aindustriosa/UnderWaterComms/README.md

# UnderWaterComms
UnderWater ultrasonic communications project
