aindustriosa/UnderWaterComms/HW/Rpi_Hat/README.md

Raspberry Pi Hat including:
- ADS8685IPWR ADC
- MAX98357A DAC
