aindustriosa/UnderWaterComms/HW/Rpi_Hat/bom/20250225 - BOM.xlsx

References | Value | Footprint | Digi-Key_PN | Quantity | 2 units
C1, C4, C6, C8, C10, C13, C14, C17, C19, C22 | 1uF | C_0603_1608Metric | 1276-1019-1-ND | 10 | 20 | 1276-1019-1-ND
C3, C5, C7, C15, C16, C18 | 10uF | C_0603_1608Metric | 1276-1869-1-ND | 6 | 12 | 1276-1869-1-ND
C2, C9 | 4.7uF | C_0603_1608Metric | 1276-1784-1-ND | 2 | 4 | 1276-1784-1-ND
C11, C12 | 100nF | C_0603_1608Metric | 1276-1000-1-ND | 2 | 4 | 1276-1000-1-ND
C20, C21 | 220pF | C_0603_1608Metric | 1276-1986-1-ND | 2 | 4 | 1276-1986-1-ND
R1, R5, R6 | 100K | R_0603_1608Metric | RMCF0603FT100KCT-ND | 3 | 6 | RMCF0603FT100KCT-ND
R3, R4 | 10R | R_0603_1608Metric | RMCF0603FT10R0CT-ND | 2 | 4 | RMCF0603FT10R0CT-ND
R2 | 2K2 | R_0603_1608Metric | P2.2KGCT-ND | 1 | 2 | P2.2KGCT-ND
U1 | ADS8685IPWR | TSSOP-16_4.4x5mm_P0.65mm | 296-48485-1-ND | 1 | 2 | 296-48485-1-ND
U2 | MD112D-05B | Converter_DCDC_TRACO_TBA1-xxxxE_Dual_THT | 5943-MD112D-05B-ND | 1 | 2 | 5943-MD112D-05B-ND
U3 | INA126 | SOIC-8_3.9x4.9mm_P1.27mm | 296-38946-1-ND | 1 | 2 | 296-38946-1-ND
U4 | AP7380-33W5 | SOT-23-5 | AP7380-33W5-7DICT-ND | 1 | 2 | AP7380-33W5-7DICT-ND
U5 | MAX98357A | TQFN-16-1EP_3x3mm_P0.5mm_EP1.23x1.23mm | MAX98357AETE+TCT-ND | 1 | 2 | MAX98357AETE+TCT-ND
TP1, TP2, TP3, TP4, TP5, TP6, TP7 | TestPoint | TestPoint_Pad_2.0x2.0mm |  | 7
RV1, RV2 | 10K | TRIM_PV37W103C01B00 | 490-2970-ND | 2 | 4 | 490-2970-ND
J1, J2 | Conn_01x02 | TerminalBlock_Phoenix_PT-1,5-2-3.5-H_1x02_P3.50mm_Horizontal | 277-1721-ND | 2 | 4 | 277-1721-ND
J3 | GPIO | PinSocket_2x20_P2.54mm_Vertical | 732-61304021821-ND | 1 | 2 | 732-61304021821-ND
J4 | Gain_select | PinHeader_2x04_P2.54mm_Vertical | 2057-PH2-08-UA-ND | 1 | 2 | 2057-PH2-08-UA-ND
