aindustriosa/UnderWaterComms/HW/Rpi_Hat/3D/tba1e_dual_3d_drawing.stp

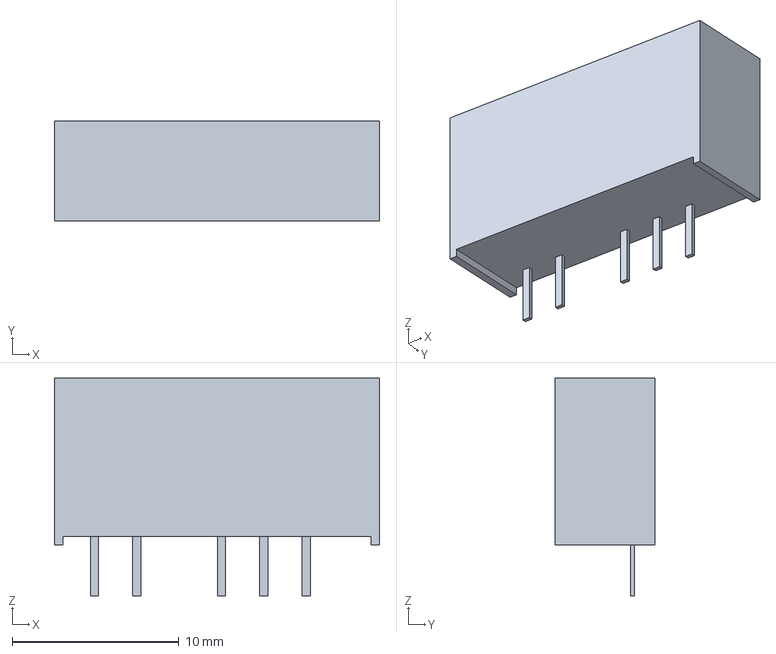
[picture p1: CAD file, 2025-02-27]
HW/Rpi_Hat/3D/tba1e_dual_3d_drawing.stp
19.5 x 6.00 x 13.1 mm
