aindustriosa/UnderWaterComms/HW/Rpi_Hat/3D/PV37W103C01B00.step

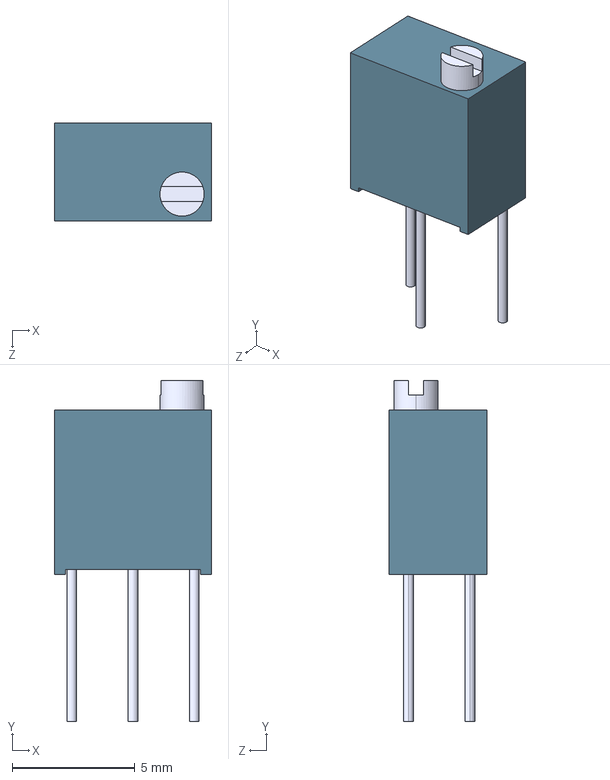
[picture p2: CAD file, 2025-02-27]
HW/Rpi_Hat/3D/PV37W103C01B00.step
6.40 x 13.9 x 4.00 mm
