aindustriosa/UnderWaterComms/HW/Rpi_Hat/3D/MAX98357AETE_T.step

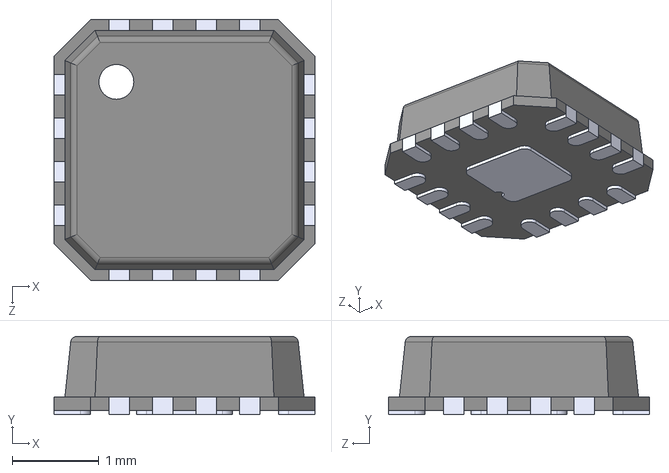
[picture p3: CAD file, 2025-02-27]
HW/Rpi_Hat/3D/MAX98357AETE_T.step
3.00 x 0.9 x 3.00 mm
