aindustriosa/UnderWaterComms/HW/Rpi_Hat/ADC_16bit_board_v0r0.kicad_pcb

## KiCad design HW/Rpi_Hat/ADC_16bit_board_v0r0.kicad_pcb (2025-02-27)

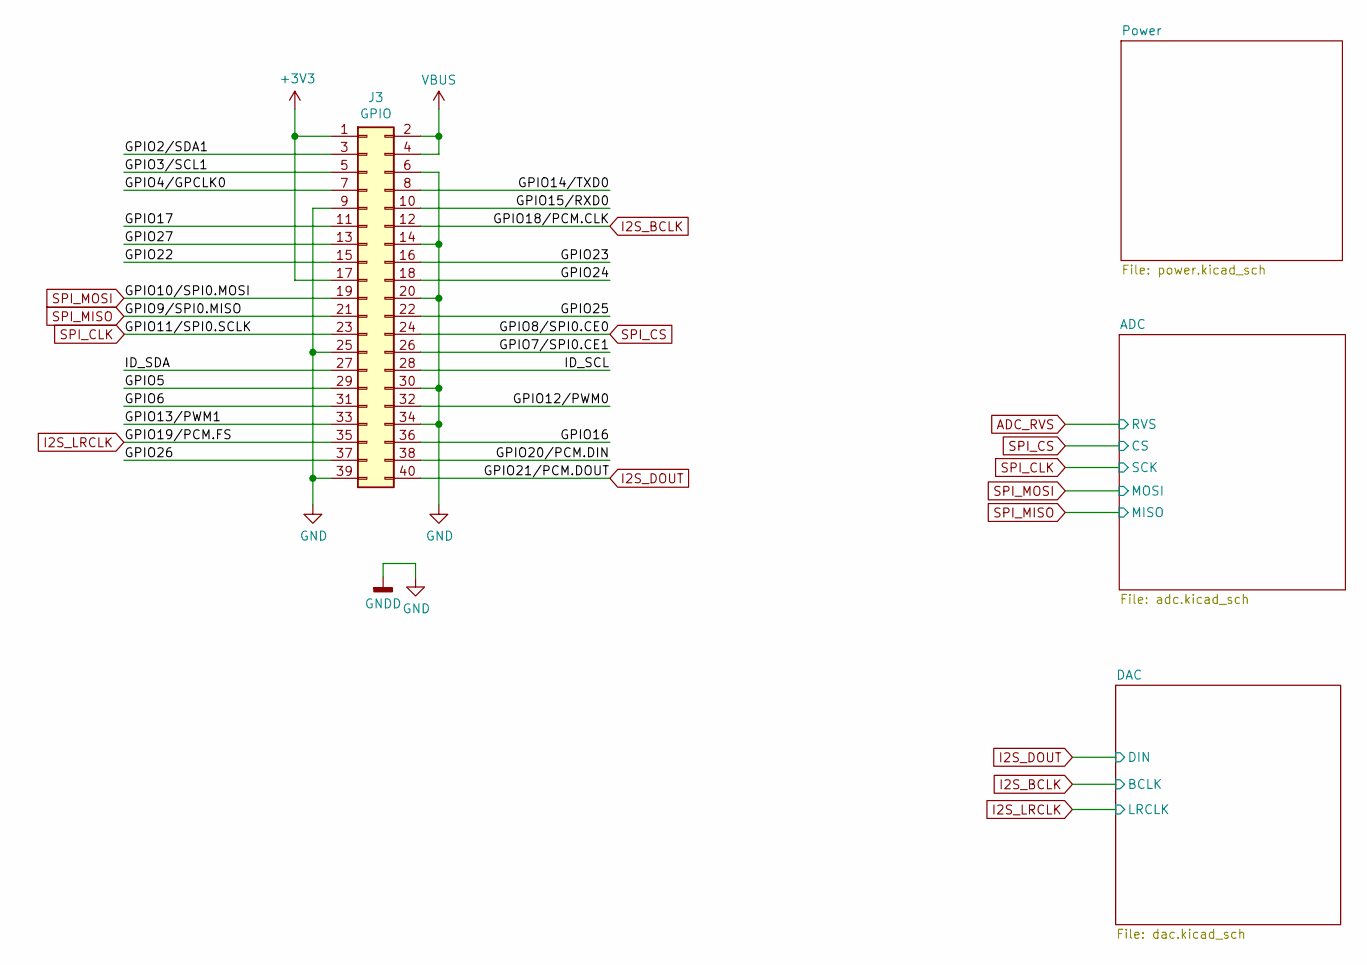
[picture p4: schematic ADC_16bit_board_v0r0.kicad_sch]

Parts:
J3: GPIO; PinSocket_2x20_P2.54mm_Vertical; Digi-Key_PN 732-61304021821-ND

Connections:
+3V3: J3.1, J3.17
/GPIO2/SDA1: J3.3
/GPIO3/SCL1: J3.5
/GPIO4/GPCLK0: J3.7
/GPIO5: J3.29
/GPIO6: J3.31
/GPIO7/SPI0.CE1: J3.26
/GPIO12/PWM0: J3.32
/GPIO13/PWM1: J3.33
/GPIO14/TXD0: J3.8
/GPIO15/RXD0: J3.10
/GPIO16: J3.36
/GPIO17: J3.11
/GPIO20/PCM.DIN: J3.38
/GPIO22: J3.15
/GPIO23: J3.16
/GPIO24: J3.18
/GPIO25: J3.22
/GPIO26: J3.37
/GPIO27: J3.13
/ID_SCL: J3.28
/ID_SDA: J3.27
GND: J3.6, J3.9, J3.14, J3.20, J3.25, J3.30, J3.34, J3.39; also elsewhere on the board
I2S_BCLK: J3.12; also elsewhere on the board
I2S_DOUT: J3.40; also elsewhere on the board
I2S_LRCLK: J3.35; also elsewhere on the board
SPI_CLK: J3.23; also elsewhere on the board
SPI_CS: J3.24; also elsewhere on the board
SPI_MISO: J3.21; also elsewhere on the board
SPI_MOSI: J3.19; also elsewhere on the board
VBUS: J3.2, J3.4; also elsewhere on the board

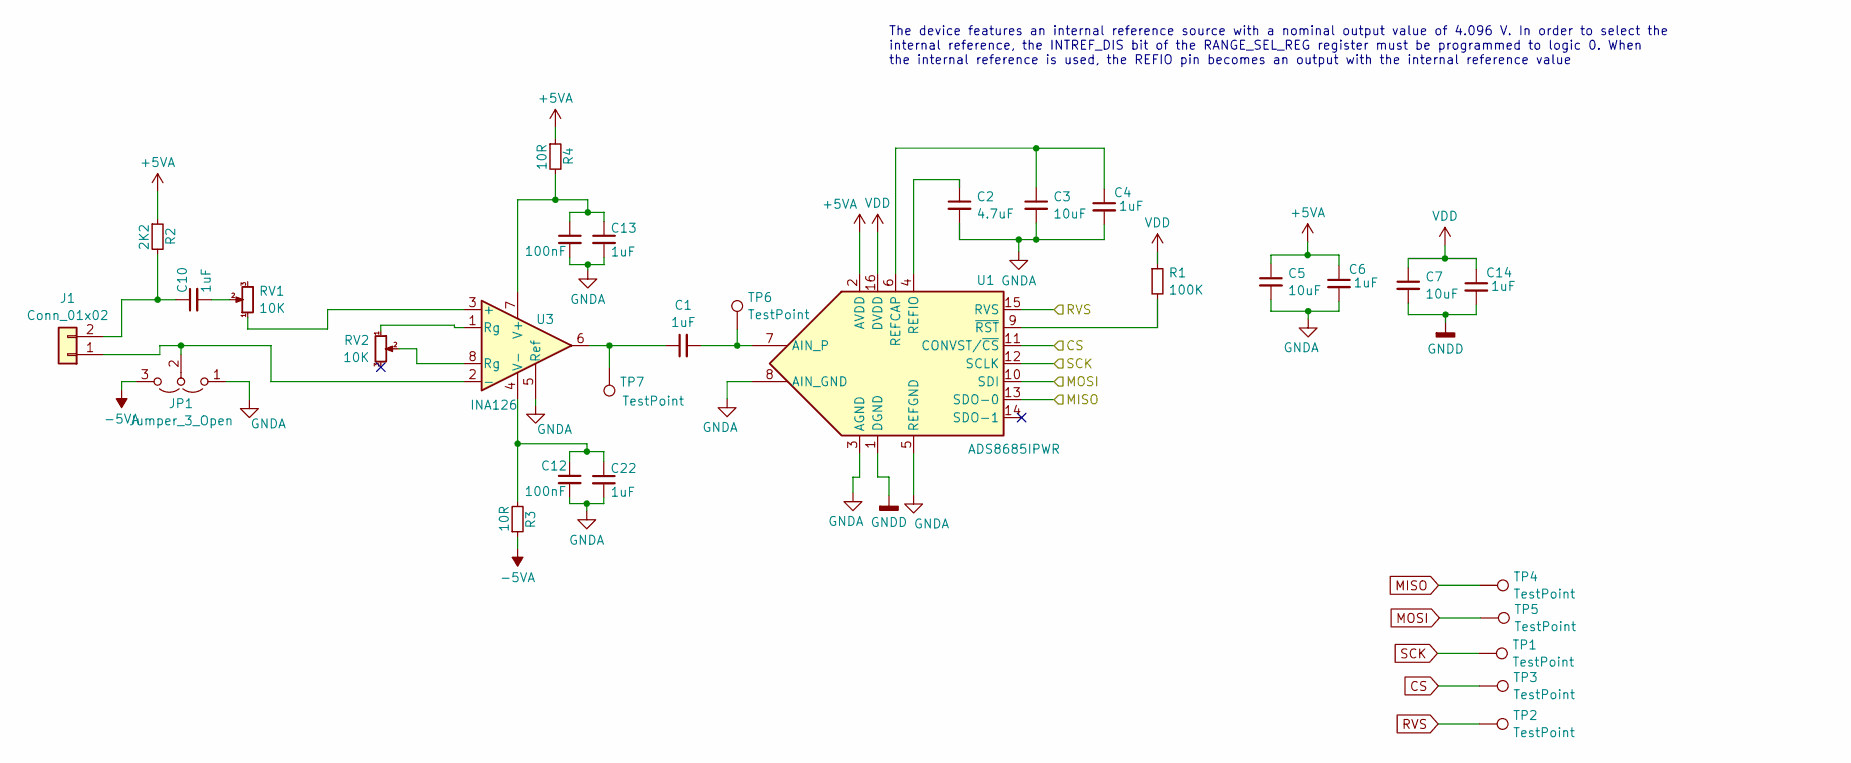
[picture p5: schematic adc.kicad_sch]

Parts:
C1, C4, C6, C10, C13, C14, C22: 1uF; C_0603_1608Metric; Digi-Key_PN 1276-1019-1-ND
C2: 4.7uF; C_0603_1608Metric; Digi-Key_PN 1276-1784-1-ND
C3, C5, C7: 10uF; C_0603_1608Metric; Digi-Key_PN 1276-1869-1-ND
C11, C12: 100nF; C_0603_1608Metric; Digi-Key_PN 1276-1000-1-ND
J1: Conn_01x02; TerminalBlock_Phoenix_PT-1,5-2-3.5-H_1x02_P3.50mm_Horizontal; Digi-Key_PN 277-1721-ND
JP1: Jumper_3_Open; SolderJumper-3_P1.3mm_Open_RoundedPad1.0x1.5mm
R1: 100K; R_0603_1608Metric; Digi-Key_PN RMCF0603FT100KCT-ND
R2: 2K2; R_0603_1608Metric; Digi-Key_PN P2.2KGCT-ND
R3, R4: 10R; R_0603_1608Metric; Digi-Key_PN RMCF0603FT10R0CT-ND
RV1, RV2: 10K; TRIM_PV37W103C01B00; Digi-Key_PN 490-2970-ND
TP1, TP2, TP3, TP4, TP5, TP6, TP7: TestPoint; TestPoint_Pad_2.0x2.0mm
U1: ADS8685IPWR; TSSOP-16_4.4x5mm_P0.65mm; Digi-Key_PN 296-48485-1-ND
U3: INA126; SOIC-8_3.9x4.9mm_P1.27mm; Digi-Key_PN 296-38946-1-ND

Connections:
+5VA: C5.1, C6.1, R2.1, R4.1, U1.2 (AVDD); also elsewhere on the board
-5VA: JP1.3 (B), R3.1; also elsewhere on the board
ADC_RVS: TP2.1, U1.15 (RVS)
GND: C7.2, C14.2, U1.1 (DGND); also elsewhere on the board
GNDA: C2.2, C3.2, C4.2, C5.2, C6.2, C11.2, C12.2, C13.2, C22.2, JP1.1 (A), U1.3 (AGND), U1.5 (REFGND), U1.8 (AIN_GND), U3.5 (Ref); also elsewhere on the board
unnamed: C1.1, TP7.1, U3.6
unnamed: C10.2, RV1.2
unnamed: J1.1, JP1.2 (C), U3.2 (-)
unnamed: C10.1, J1.2, R2.2
unnamed: RV2.1, U3.1 (Rg)
unnamed: RV2.2, U3.8 (Rg)
unnamed: C1.2, TP6.1, U1.7 (AIN_P)
unnamed: C3.1, C4.1, U1.6 (REFCAP)
unnamed: C2.1, U1.4 (REFIO)
unnamed: R1.2, U1.9 (~RST)
unnamed: RV1.1, U3.3 (+)
unnamed: C11.1, C13.1, R4.2, U3.7 (V+)
unnamed: C12.1, C22.1, R3.2, U3.4 (V-)
SPI_CLK: TP1.1, U1.12 (SCLK); also elsewhere on the board
SPI_CS: TP3.1, U1.11 (CONVST/~CS); also elsewhere on the board
SPI_MISO: TP4.1, U1.13 (SDO-0); also elsewhere on the board
SPI_MOSI: TP5.1, U1.10 (SDI); also elsewhere on the board
VDD: C7.1, C14.1, R1.1, U1.16 (DVDD); also elsewhere on the board

Notes on the sheet:
The device features an internal reference source with a nominal output value of 4.096 V. In order to select the internal reference, the INTREF_DIS bit of the RANGE_SEL_REG register must be programmed to logic 0. When the internal reference is used, the REFIO pin becomes an output with the internal 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

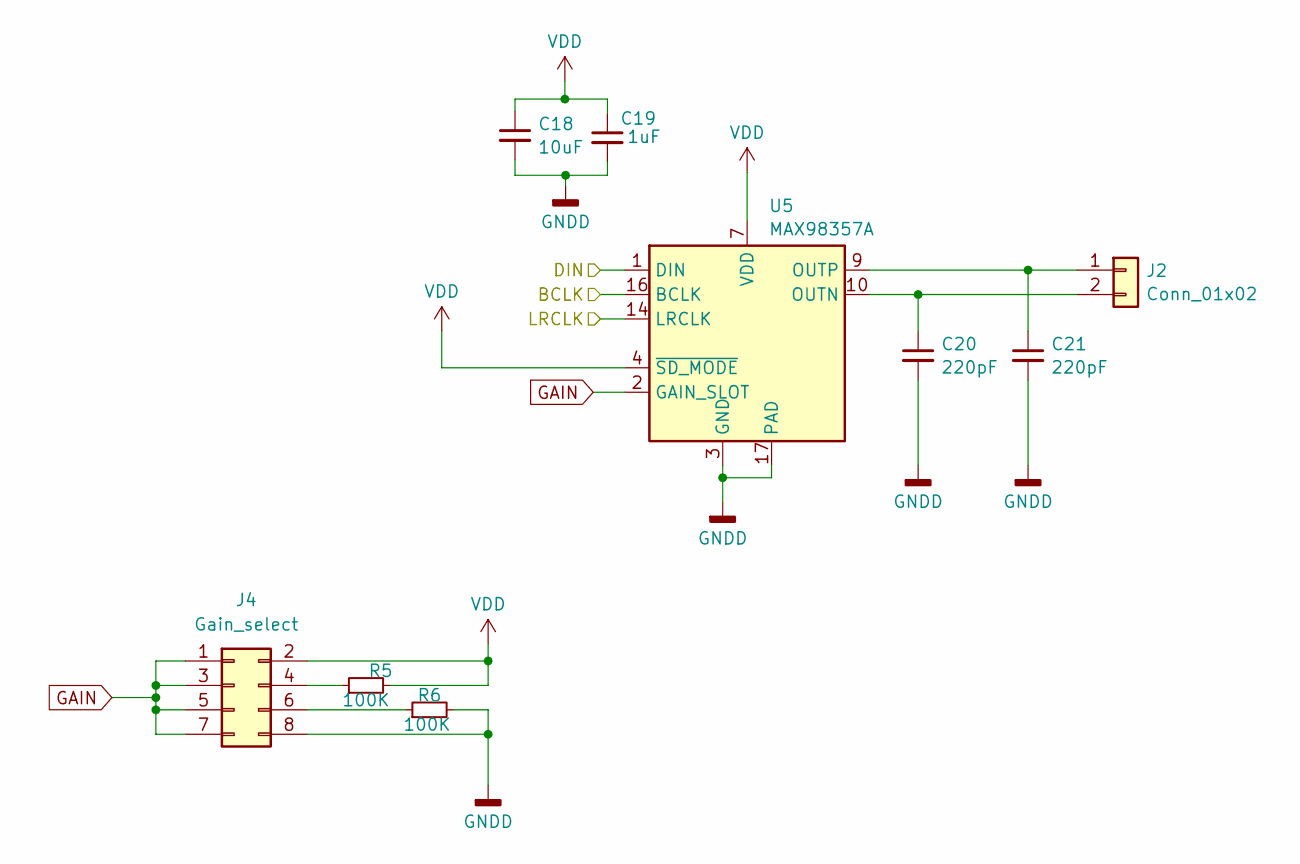
[picture p6: schematic dac.kicad_sch]

Parts:
C18: 10uF; C_0603_1608Metric; Digi-Key_PN 1276-1869-1-ND
C19: 1uF; C_0603_1608Metric; Digi-Key_PN 1276-1019-1-ND
C20, C21: 220pF; C_0603_1608Metric; Digi-Key_PN 1276-1986-1-ND
J2: Conn_01x02; TerminalBlock_Phoenix_PT-1,5-2-3.5-H_1x02_P3.50mm_Horizontal; Digi-Key_PN 277-1721-ND
J4: Gain_select; PinHeader_2x04_P2.54mm_Vertical; Digi-Key_PN 2057-PH2-08-UA-ND
R5, R6: 100K; R_0603_1608Metric; Digi-Key_PN RMCF0603FT100KCT-ND
U5: MAX98357A; TQFN-16-1EP_3x3mm_P0.5mm_EP1.23x1.23mm; Digi-Key_PN MAX98357AETE+TCT-ND

Connections:
GAIN: J4.1, J4.3, J4.5, J4.7, U5.2 (GAIN_SLOT)
GND: C18.2, C19.2, C20.2, C21.2, J4.8, R6.2, U5.3 (GND), U5.11 (GND), U5.15 (GND), U5.17 (PAD); also elsewhere on the board
I2S_BCLK: U5.16 (BCLK); also elsewhere on the board
I2S_DOUT: U5.1 (DIN); also elsewhere on the board
I2S_LRCLK: U5.14 (LRCLK); also elsewhere on the board
unnamed: C21.1, J2.1, U5.9 (OUTP)
unnamed: C20.1, J2.2, U5.10 (OUTN)
unnamed: J4.4, R5.1
unnamed: J4.6, R6.1
VDD: C18.1, C19.1, J4.2, R5.2, U5.4 (~SD_MODE), U5.7 (VDD), U5.8 (VDD); also elsewhere on the board

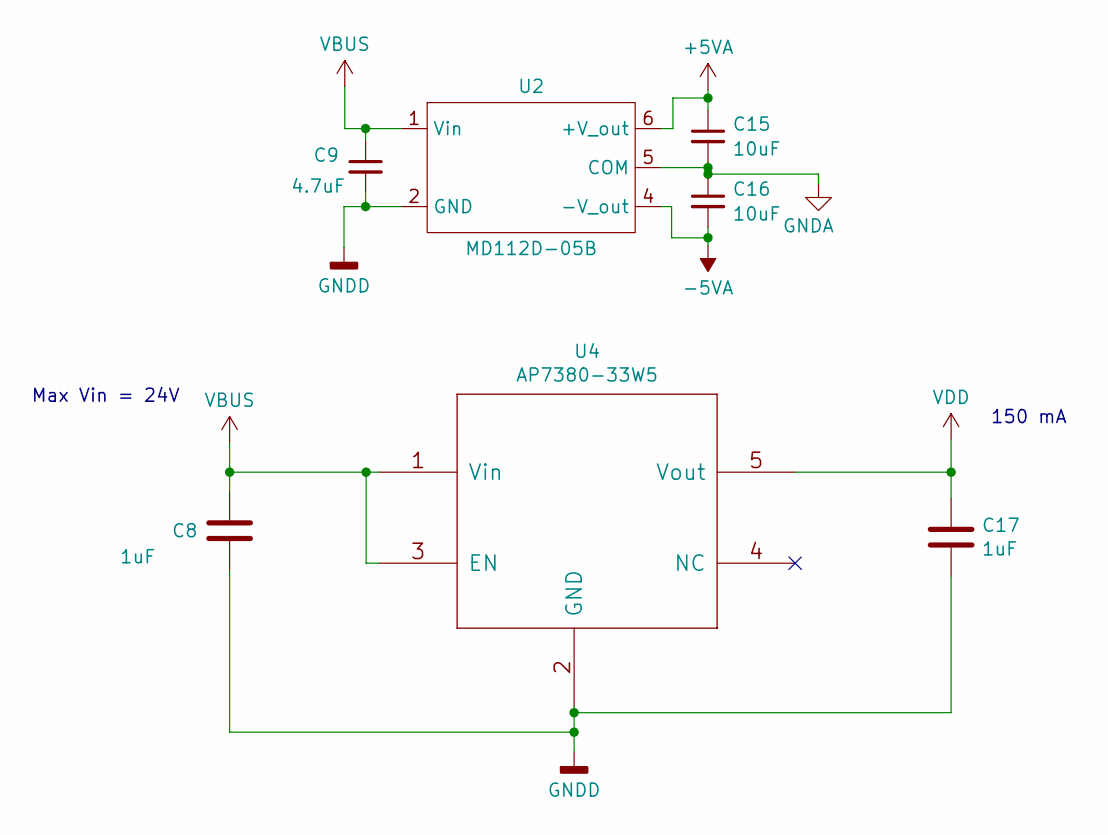
[picture p7: schematic power.kicad_sch]

Parts:
C8, C17: 1uF; C_0603_1608Metric; Digi-Key_PN 1276-1019-1-ND
C9: 4.7uF; C_0603_1608Metric; Digi-Key_PN 1276-1784-1-ND
C15, C16: 10uF; C_0603_1608Metric; Digi-Key_PN 1276-1869-1-ND
U2: MD112D-05B; Converter_DCDC_TRACO_TBA1-xxxxE_Dual_THT; Digi-Key_PN 5943-MD112D-05B-ND
U4: AP7380-33W5; SOT-23-5; Digi-Key_PN AP7380-33W5-7DICT-ND

Connections:
+5VA: C15.1, U2.6 (+V_out); also elsewhere on the board
-5VA: C16.2, U2.4 (-V_out); also elsewhere on the board
GND: C8.2, C9.2, C17.2, U2.2 (GND), U4.2 (GND); also elsewhere on the board
GNDA: C15.2, C16.1, U2.5 (COM); also elsewhere on the board
VBUS: C8.1, C9.1, U2.1 (Vin), U4.1 (Vin), U4.3 (EN); also elsewhere on the board
VDD: C17.1, U4.5 (Vout); also elsewhere on the board

Notes on the sheet:
Max Vin = 24V
150 mA

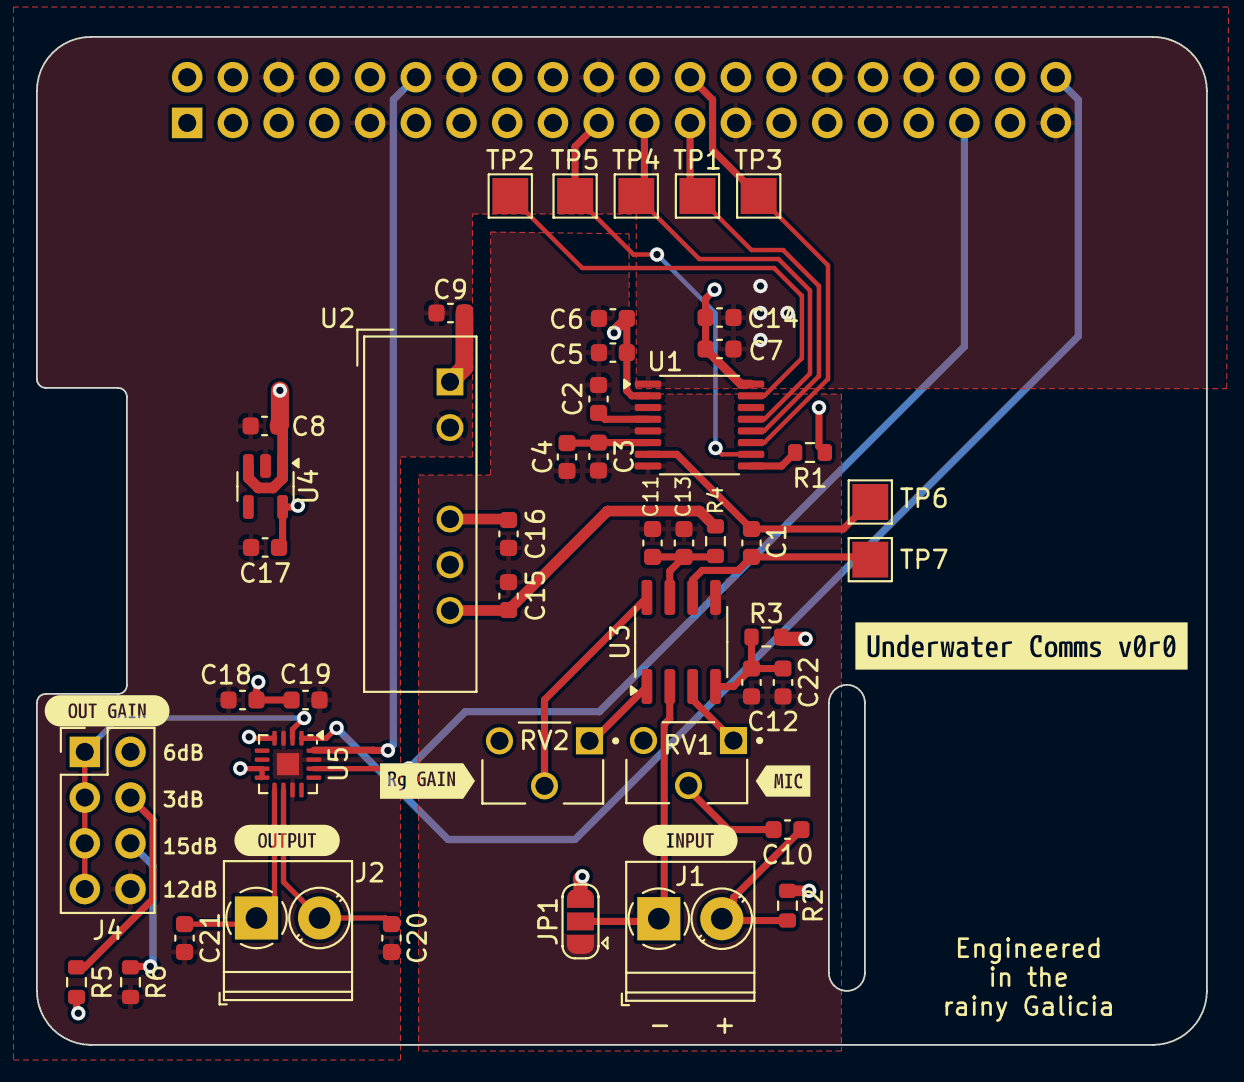
[picture p8: board ADC_16bit_board_v0r0.kicad_pcb from above]

Board: 4 copper layers, 65.0 x 56.0 mm, 53 parts (1 on the bottom side), 33 nets.

Other parts of the board:
kibuzzard-67B85FF2: G***; kibuzzard-67B85FF2
kibuzzard-67B869D1: G***; kibuzzard-67B869D1
kibuzzard-67B86721: G***; kibuzzard-67B86721
kibuzzard-67BC9731: G***; kibuzzard-67BC9731
kibuzzard-67BC9758: G***; kibuzzard-67BC9758
kibuzzard-67BD956C: G***; kibuzzard-67BD956C
